haiha-ux/pcb-lowpower-timer/fab/BOM_JLCPCB.csv

Comment | Designator | Footprint | LCSC Part #
MLT-8530 | BZ1 | Buzzer_Huaneng_MLT-8530 | C94599
10uF | C1-C3 | C_0603_1608Metric | C19702
100nF | C4,C8,C11 | C_0402_1005Metric | C1525
4.7uF | C5 | C_0603_1608Metric | C19666
10nF | C6 | C_0402_1005Metric | C15195
1uF | C7 | C_0402_1005Metric | C52923
6.8pF | C9,C10 | C_0402_1005Metric | C1576
BAT54C | D1 | SOT-23 | C22466350
1N4148W | D2 | D_SOD-123 | C81598
RED STAT | D3 | LED_0603_1608Metric | C2286
RED ALARM | D4 | LED_0603_1608Metric | C2286
2xAA | J1 | JST_PH_S2B-PH-SM4-TB_1x02-1MP_P2.00mm_Horizontal | C295747
2.2uH | L1 | L_1008_2520Metric | C2046874
DMG2305UX | Q1 | SOT-23 | C150470
AO3401A | Q3 | SOT-23 | C15127
2N7002 | Q4 | SOT-23 | C8545
MMBT3904 | Q5 | SOT-23 | C20526
100k | R1,R7,R11,R12,R14 | R_0402_1005Metric | C25741
2M | R2,R6 | R_0603_1608Metric | C22976
300k | R3 | R_0603_1608Metric | C23024
1M | R4 | R_0603_1608Metric | C22935
1M | R5,R9,R10 | R_0402_1005Metric | C26083
10k | R8 | R_0402_1005Metric | C25744
470 | R13 | R_0402_1005Metric | C25117
1k | R15,R16 | R_0402_1005Metric | C11702
ON/OFF | SW1 | SW_Push_1P1T_XKB_TS-1187A | C318884
TPS61099DRV | U1 | WSON-6-1EP_2x2mm_P0.65mm_EP1x1.6mm | C2842395
STM32L031F6P6 | U2 | TSSOP-20_4.4x6.5mm_P0.65mm | C115208
32.768kHz 7pF | Y1 | Crystal_SMD_3215-2Pin_3.2x1.5mm | C48615
