haiha-ux/pcb-lowpower-timer/(list of files, drawings)

Other design files:
reports/route.dsn
