haiha-ux/pcb-lowpower-timer/lowpower_timer.kicad_pcb

## KiCad design lowpower_timer.kicad_pcb (2026-11-10)

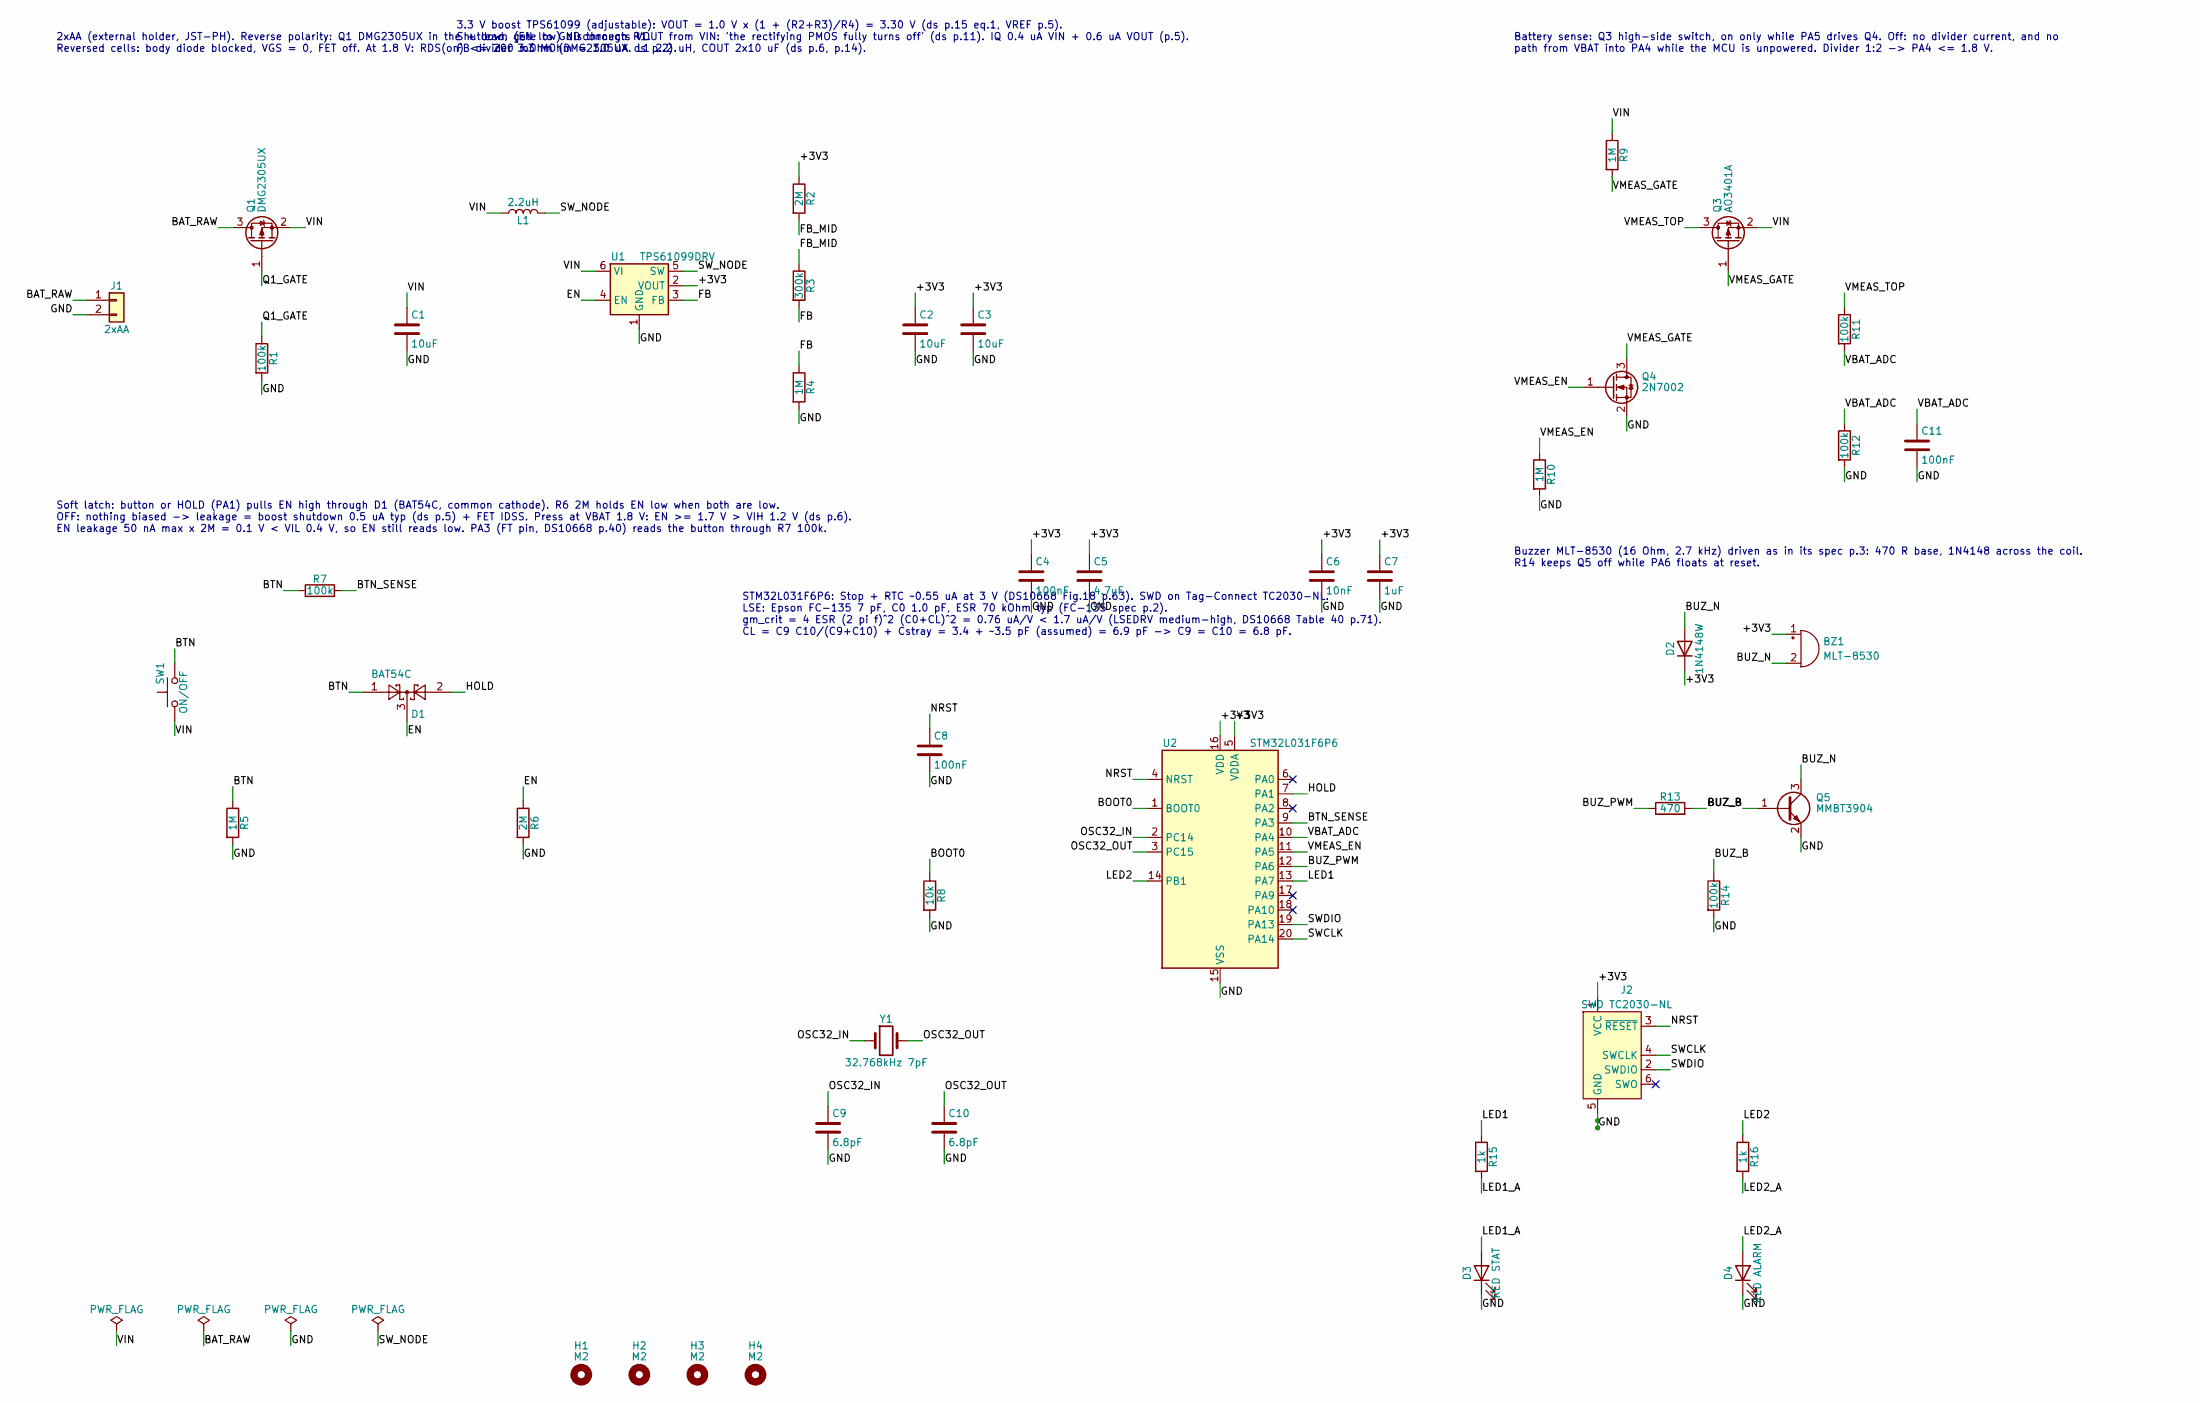
[picture p4: schematic lowpower_timer.kicad_sch]

Parts:
BZ1: MLT-8530; Buzzer_Huaneng_MLT-8530; MPN MLT-8530; JLC Extended
C1, C2, C3: 10uF; C_0603_1608Metric; MPN CL10A106KP8NNNC; JLC Basic
C4, C8, C11: 100nF; C_0402_1005Metric; MPN CL05B104KO5NNNC; JLC Basic
C5: 4.7uF; C_0603_1608Metric; MPN CL10A475KO8NNNC; JLC Basic
C6: 10nF; C_0402_1005Metric; MPN CL05B103KB5NNNC; JLC Basic
C7: 1uF; C_0402_1005Metric; MPN CL05A105KA5NQNC; JLC Basic
C9, C10: 6.8pF; C_0402_1005Metric; MPN 0402CG6R8C500NT; JLC Preferred
D1: BAT54C; SOT-23; MPN BAT54C; JLC Preferred
D2: 1N4148W; D_SOD-123; MPN 1N4148W; JLC Basic
D3: RED STAT; LED_0603_1608Metric; MPN KT-0603R; JLC Basic
D4: RED ALARM; LED_0603_1608Metric; MPN KT-0603R; JLC Basic
H1, H2, H3, H4: M2; MountingHole_2.2mm_M2
J1: 2xAA; JST_PH_S2B-PH-SM4-TB_1x02-1MP_P2.00mm_Horizontal; MPN S2B-PH-SM4-TB(LF)(SN); JLC Extended
J2: SWD TC2030-NL; Tag-Connect_TC2030-IDC-NL_2x03_P1.27mm_Vertical
L1: 2.2uH; L_1008_2520Metric; MPN 74404024022; JLC Extended
Q1: DMG2305UX; SOT-23; MPN DMG2305UX-7; JLC Extended
Q3: AO3401A; SOT-23; MPN AO3401A; JLC Basic
Q4: 2N7002; SOT-23; MPN 2N7002; JLC Basic
Q5: MMBT3904; SOT-23; MPN MMBT3904(RANGE:100-300); JLC Basic
R1, R7, R11, R12, R14: 100k; R_0402_1005Metric; MPN 0402WGF1003TCE; JLC Basic
R2, R6: 2M; R_0603_1608Metric; MPN 0603WAF2004T5E; JLC Basic
R3: 300k; R_0603_1608Metric; MPN 0603WAF3003T5E; JLC Basic
R4: 1M; R_0603_1608Metric; MPN 0603WAF1004T5E; JLC Basic
R5, R9, R10: 1M; R_0402_1005Metric; MPN 0402WGF1004TCE; JLC Basic
R8: 10k; R_0402_1005Metric; MPN 0402WGF1002TCE; JLC Basic
R13: 470; R_0402_1005Metric; MPN 0402WGF4700TCE; JLC Basic
R15, R16: 1k; R_0402_1005Metric; MPN 0402WGF1001TCE; JLC Basic
SW1: ON/OFF; SW_Push_1P1T_XKB_TS-1187A; MPN TS-1187A-B-A-B; JLC Basic
U1: TPS61099DRV; WSON-6-1EP_2x2mm_P0.65mm_EP1x1.6mm; MPN TPS61099DRVR; JLC Extended
U2: STM32L031F6P6; TSSOP-20_4.4x6.5mm_P0.65mm; MPN STM32L031F6P6; JLC Extended
Y1: 32.768kHz 7pF; Crystal_SMD_3215-2Pin_3.2x1.5mm; MPN Q13FC13500002; JLC Extended

Connections:
/+3V3: BZ1.1 (+), C2.1, C3.1, C4.1, C5.1, C6.1, C7.1, D2.1 (K), J2.1 (VCC), R2.1, U1.2 (VOUT), U2.5 (VDDA), U2.16 (VDD)
/BAT_RAW: J1.1, Q1.3 (D)
/BOOT0: R8.1, U2.1 (BOOT0)
/BTN: D1.1, R5.1, R7.1, SW1.2
/BTN_SENSE: R7.2, U2.9 (PA3)
/BUZ_B: Q5.1 (B), R13.2, R14.1
/BUZ_N: BZ1.2 (-), D2.2 (A), Q5.3 (C)
/BUZ_PWM: R13.1, U2.12 (PA6)
/EN: D1.3, R6.1, U1.4 (EN)
/FB: R3.2, R4.1, U1.3 (FB)
/FB_MID: R2.2, R3.1
/GND: C1.2, C2.2, C3.2, C4.2, C5.2, C6.2, C7.2, C8.2, C9.2, C10.2, C11.2, D3.1 (K), D4.1 (K), J1.2, J2.5 (GND), Q4.2 (S), Q5.2 (E), R1.2, R4.2, R5.2, R6.2, R8.2, R10.2, R12.2, R14.2, U1.1 (GND), U1.7 (GND), U2.15 (VSS)
/HOLD: D1.2, U2.7 (PA1)
/LED1: R15.1, U2.13 (PA7)
/LED1_A: D3.2 (A), R15.2
/LED2: R16.1, U2.14 (PB1)
/LED2_A: D4.2 (A), R16.2
/NRST: C8.1, J2.3 (~RESET), U2.4 (NRST)
/OSC32_IN: C9.1, U2.2 (PC14), Y1.1
/OSC32_OUT: C10.1, U2.3 (PC15), Y1.2
/Q1_GATE: Q1.1 (G), R1.1
/SWCLK: J2.4 (SWCLK), U2.20 (PA14)
/SWDIO: J2.2 (SWDIO), U2.19 (PA13)
/SW_NODE: L1.2, U1.5 (SW)
/VBAT_ADC: C11.1, R11.2, R12.1, U2.10 (PA4)
/VIN: C1.1, L1.1, Q1.2 (S), Q3.2 (S), R9.1, SW1.1, U1.6 (VI)
/VMEAS_EN: Q4.1 (G), R10.1, U2.11 (PA5)
/VMEAS_GATE: Q3.1 (G), Q4.3 (D), R9.2
/VMEAS_TOP: Q3.3 (D), R11.1

Notes on the sheet:
2xAA (external holder, JST-PH). Reverse polarity: Q1 DMG2305UX in the + lead, gate to GND through R1. Reversed cells: body diode blocked, VGS = 0, FET off. At 1.8 V: RDS(on) <= 200 mOhm (DMG2305UX ds p.2).
3.3 V boost TPS61099 (adjustable): VOUT = 1.0 V x (1 + (R2+R3)/R4) = 3.30 V (ds p.15 eq.1, VREF p.5). Shutdown (EN low) disconnects VOUT from VIN: 'the rectifying PMOS fully turns off' (ds p.11). IQ 0.4 uA VIN + 0.6 uA VOUT (p.5). FB divider 3.3 MOhm = 1.0 uA. L1 2.2 uH, COUT 2x10 uF (ds p.6, p.14).
Soft latch: button or HOLD (PA1) pulls EN high through D1 (BAT54C, common cathode). R6 2M holds EN low when both are low. OFF: nothing biased -> leakage = boost shutdown 0.5 uA typ (ds p.5) + FET IDSS. Press at VBAT 1.8 V: EN >= 1.7 V > VIH 1.2 V (ds p.6). EN leakage 50 nA max x 2M = 0.1 V < VIL 0.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
STM32L031F6P6: Stop + RTC ~0.55 uA at 3 V (DS10668 Fig.18 p.63). SWD on Tag-Connect TC2030-NL. LSE: Epson FC-135 7 pF, C0 1.0 pF, ESR 70 kOhm typ (FC-135 spec p.2). gm_crit = 4 ESR (2 pi f)^2 (C0+CL)^2 = 0.76 uA/V < 1.7 uA/V (LSEDRV medium-high, DS10668 Table 40 p.71). CL = C9 C10/(C9+C10) + Cstray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
Battery sense: Q3 high-side switch, on only while PA5 drives Q4. Off: no divider current, and no path from VBAT into PA4 while the MCU is unpowered. Divider 1:2 -> PA4 <= 1.8 V.
Buzzer MLT-8530 (16 Ohm, 2.7 kHz) driven as in its spec p.3: 470 R base, 1N4148 across the coil. R14 keeps Q5 off while PA6 floats at reset.

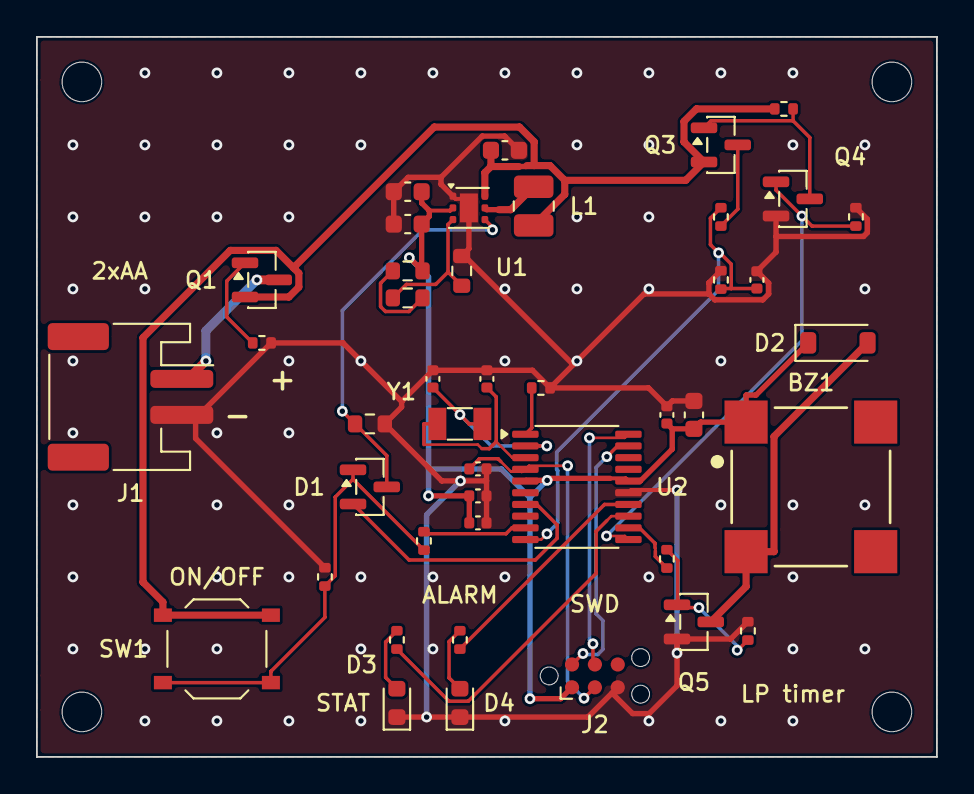
[picture p5: board lowpower_timer.kicad_pcb from above]

Board: 2 copper layers, 50.0 x 40.0 mm, 47 parts (0 on the bottom side), 29 nets.
