haiha-ux/pcb-lowpower-timer/(commit log)

2026-11-10 Schematic: 2xAA timer with soft-latch boost, STM32L031 + 32k RTC, buzzer, switched battery sense
    [BOM_JLCPCB.csv, lowpower_timer.kicad_pcb, lowpower_timer.kicad_sch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]
2026-11-10 PCB layout 2-layer 50x40, fab outputs; buzzer footprint per EasyEDA pad geometry; README: down mode, PFM VREF, power-off sequence, programming, leakage figures
    [BOM_JLCPCB.csv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]
2026-11-10 CPL: WSON-6 +270 (local entry); silkscreen references for U1, Q4, Q5
    [CPL_JLCPCB.csv, cpl_rotations_local.csv, lowpower_timer-B_Cu.gbl, lowpower_timer-B_Mask.gbs, lowpower_timer-B_Paste.gbp, lowpower_timer-B_Silkscreen.gbo, lowpower_timer-Edge_Cuts.gm1, lowpower_timer-F_Cu.gtl]
